Fel-Br/FYB/README.md

# FYB
Este repositório contém os compontentes CAD, seus respectivos detalhamentos técnicos e o código utilizado no projeto do Manipulador robótico palelo acionado por cabeamento 1R2T do trabalho de conclusão de curso de Felype Araujo Brasil.
