Fel-Br/FYB/STEP/fybufpr_asm.stp

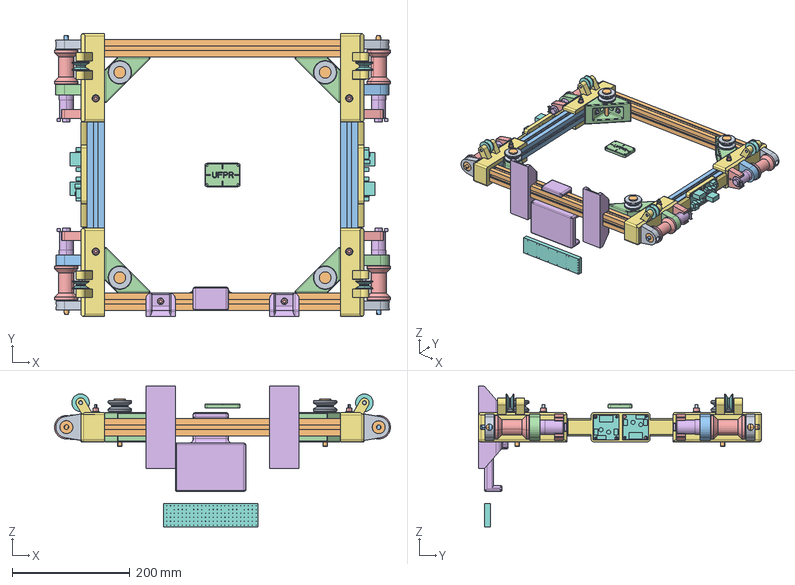
[picture p1: CAD file, 2025-05-26]
STEP/fybufpr_asm.stp
570.0 x 480.0 x 238.7 mm
FYBUFPR002 x 2
FYBUFPR001 x 2
FYBUFPR003 x 4
FYBUFPR004_001 x 2
MOTOR_6V_C-ENCODER x 4
FYBUFPR004_002 x 2
ACOP-HEX-M4 x 4
FYBUFPR004_003 x 2
ROLAMENTO x 8
FYBUFPR004_005 x 2
FYBUFPR004_006 x 2
FYBUFPR004_007 x 2
PARAF-ESC-M4X10 x 8
FYBUFPR004_004 x 2
FYBUFPR013_007 x 6
FYBUFPR005 x 4
FYBUFPR006 x 4
FYBUFPR007 x 4
PORCA_MARTELO_M8 x 17
ARUELA x 4
PARAF_M6X16 x 17
FYBUFPR011 x 2
FYBUFPR009 x 2
PONTEHL298N x 4
FYBUFPR012 x 4
FYBUFPR013_001 x 2
FYBUFPR013_002 x 2
FYBUFPR013_003 x 2
FYBUFPR013_004 x 2
FYBUFPR013_005 x 2
FYBUFPR013_006 x 2
FYBUFPR010
PARAF-M3-5X5 x 8
FYBUFPR008
PARAF_SEXTINT_ABAULADO_M8X16 x 4
PROTOBOARD
ARDUINO
