Fel-Br/FYB/STEP/fybufpr013_006.stp

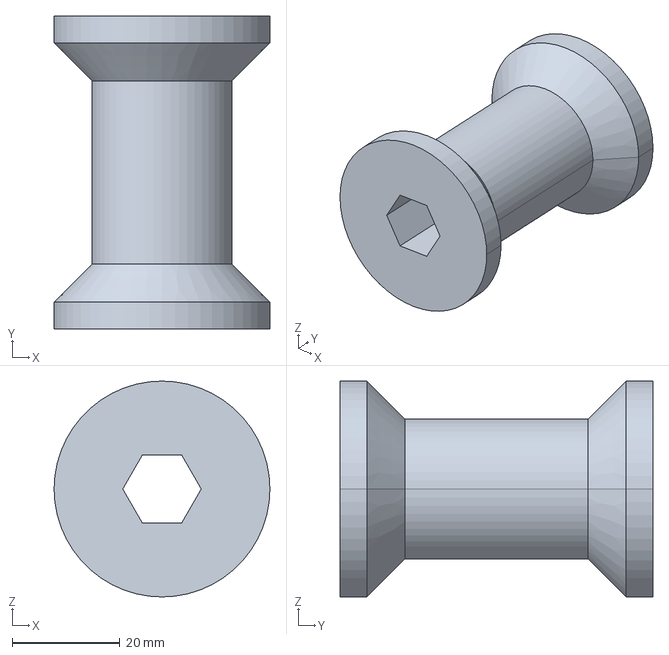
[picture p2: CAD file, 2025-05-26]
STEP/fybufpr013_006.stp
40.0 x 58.0 x 40.0 mm
