Fel-Br/FYB/Stl/fybufpr006_body_1_b.stl

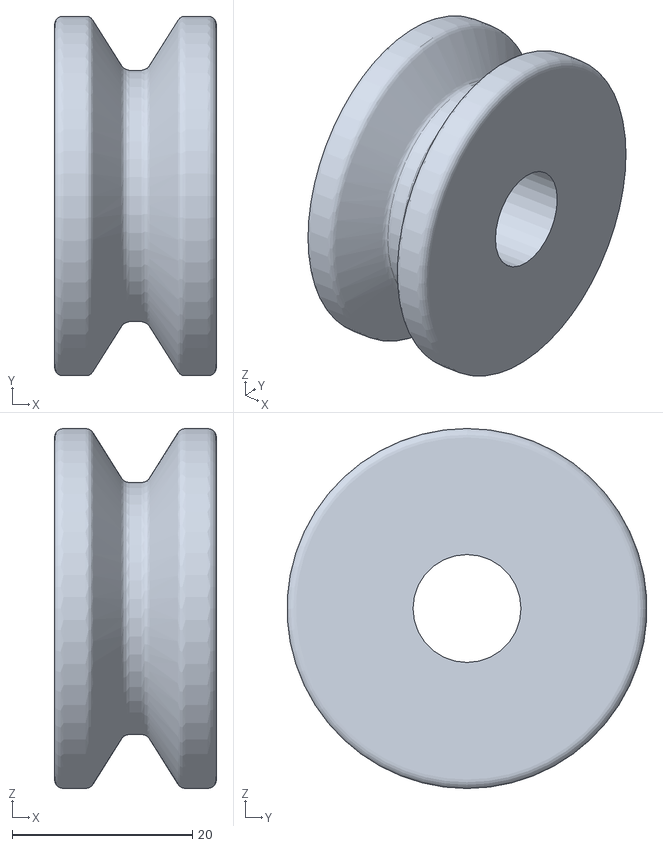
[picture p3: CAD file, 2025-05-26]
Stl/fybufpr006_body_1_b.stl
18.0 x 39.9 x 40.0
