Fel-Br/FYB/STEP/fybufpr013_004.stp

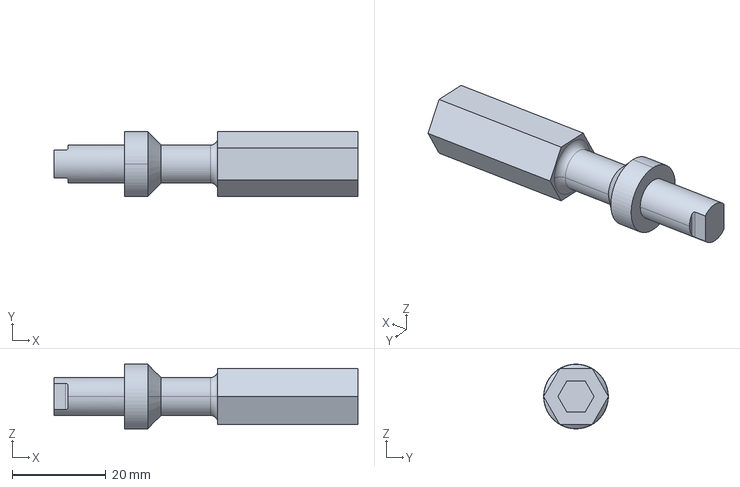
[picture p4: CAD file, 2025-05-26]
STEP/fybufpr013_004.stp
65.0 x 13.9 x 13.9 mm
