Fel-Br/FYB/Stl/fybufpr013_007_body_1_b.stl

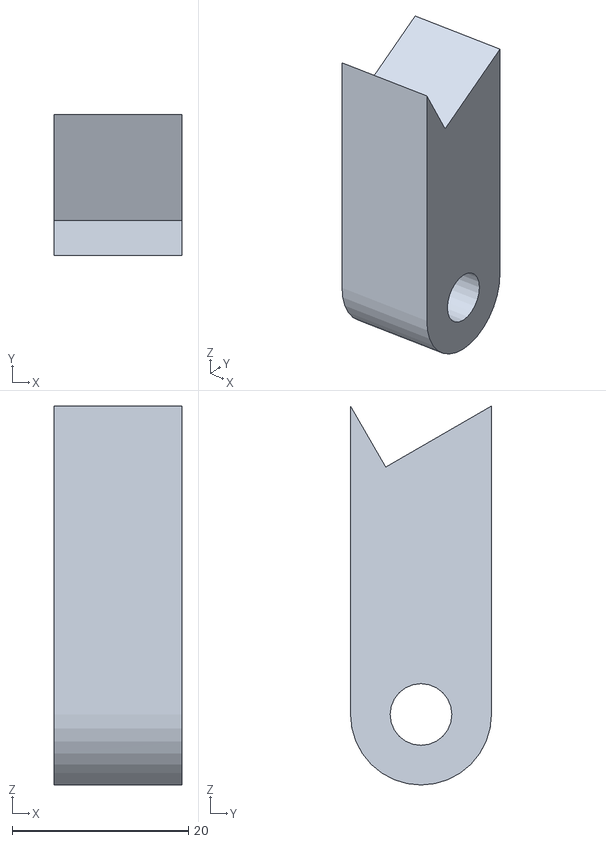
[picture p5: CAD file, 2025-05-26]
Stl/fybufpr013_007_body_1_b.stl
14.5 x 16.0 x 43.0
