Fel-Br/FYB/Stl/fybufpr004_003_body_1_b.stl

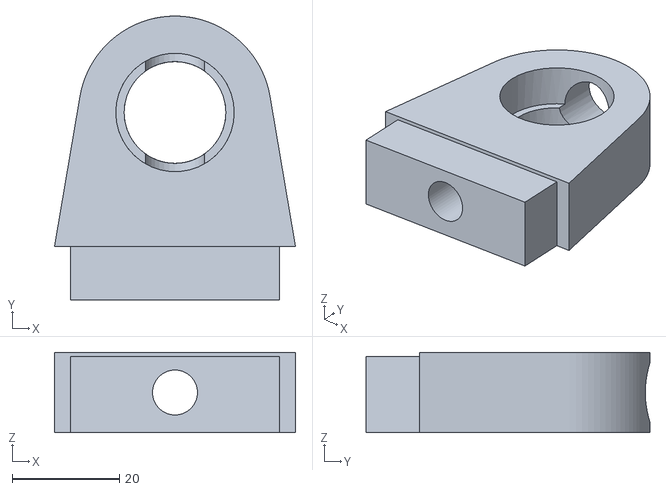
[picture p6: CAD file, 2025-05-26]
Stl/fybufpr004_003_body_1_b.stl
45.0 x 53.0 x 15.0
