Fel-Br/FYB/STEP/pontehl298n.stp

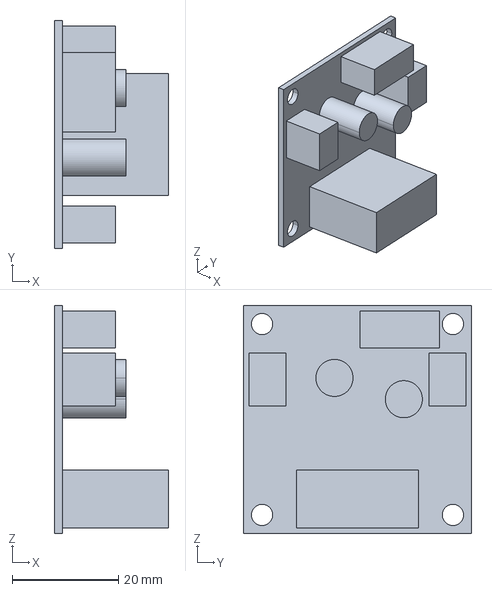
[picture p7: CAD file, 2025-05-26]
STEP/pontehl298n.stp
21.5 x 43.0 x 43.0 mm
