Fel-Br/FYB/STEP/paraf_m6x16.stp

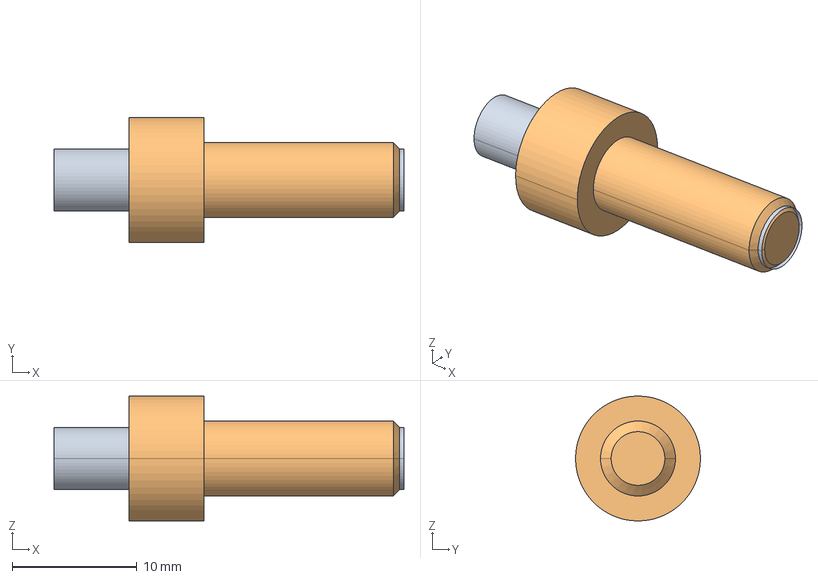
[picture p8: CAD file, 2025-05-26]
STEP/paraf_m6x16.stp
28.0 x 10.0 x 10.0 mm
