Fel-Br/FYB/Stl/fybufpr004_005_body_1_b.stl

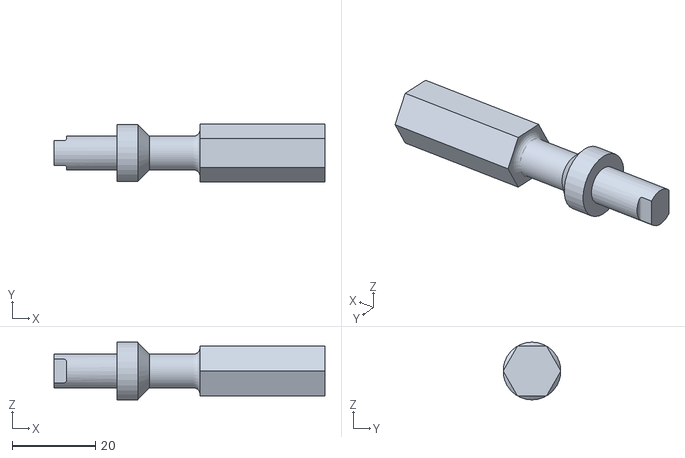
[picture p9: CAD file, 2025-05-26]
Stl/fybufpr004_005_body_1_b.stl
65.0 x 13.9 x 13.9
