Fel-Br/FYB/STEP/fybufpr001.stp

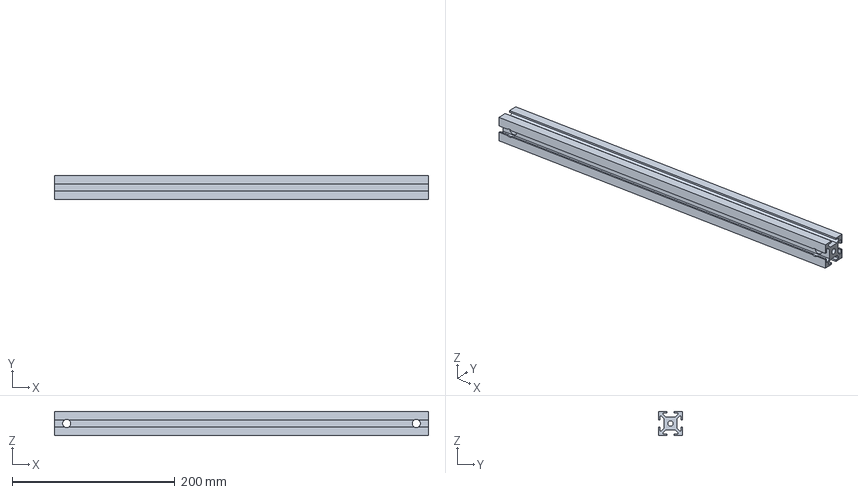
[picture p10: CAD file, 2025-05-26]
STEP/fybufpr001.stp
460.0 x 30.0 x 30.0 mm
