Fel-Br/FYB/Stl/fybufpr007_body_1_b.stl

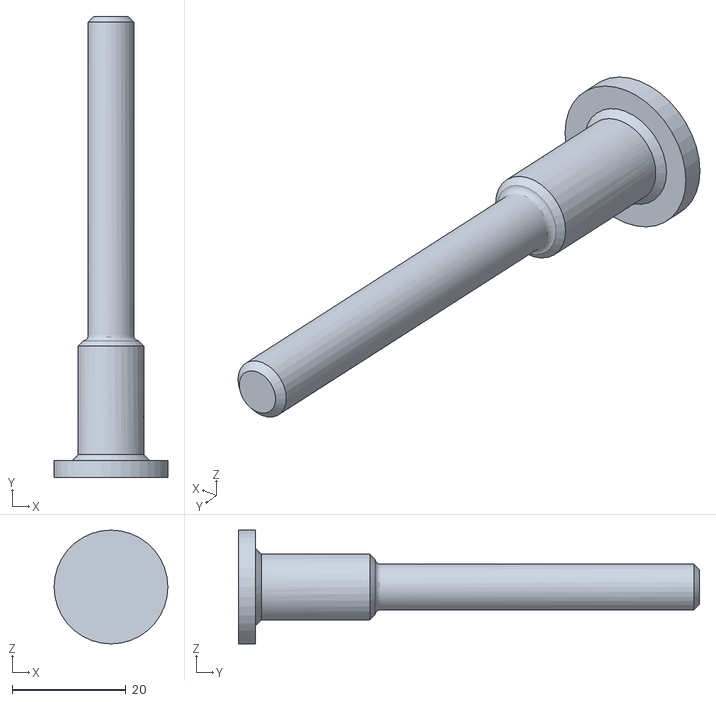
[picture p11: CAD file, 2025-05-26]
Stl/fybufpr007_body_1_b.stl
20.0 x 81.0 x 20.0
