Fel-Br/FYB/Stl/fybufpr004_001_body_1_b.stl

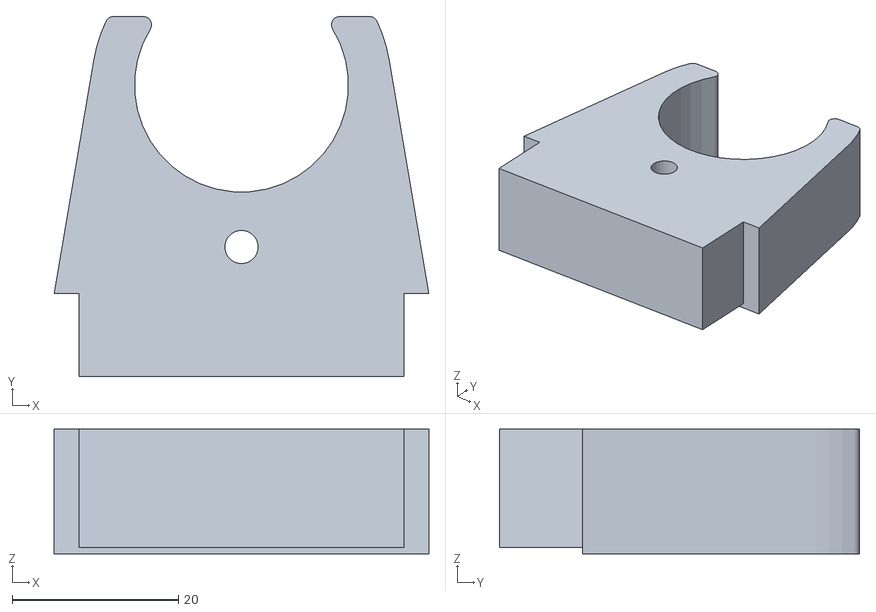
[picture p12: CAD file, 2025-05-26]
Stl/fybufpr004_001_body_1_b.stl
45.0 x 43.2 x 15.0
