Fel-Br/FYB/STEP/fybufpr004_006.stp

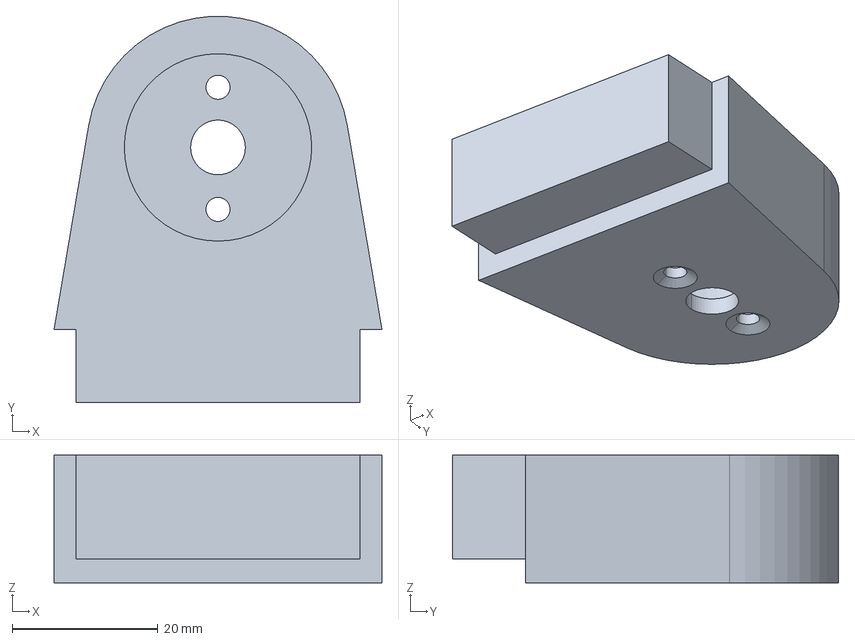
[picture p13: CAD file, 2025-05-26]
STEP/fybufpr004_006.stp
45.0 x 53.0 x 17.5 mm
