Fel-Br/FYB/Stl/fybufpr008_body_1_b.stl

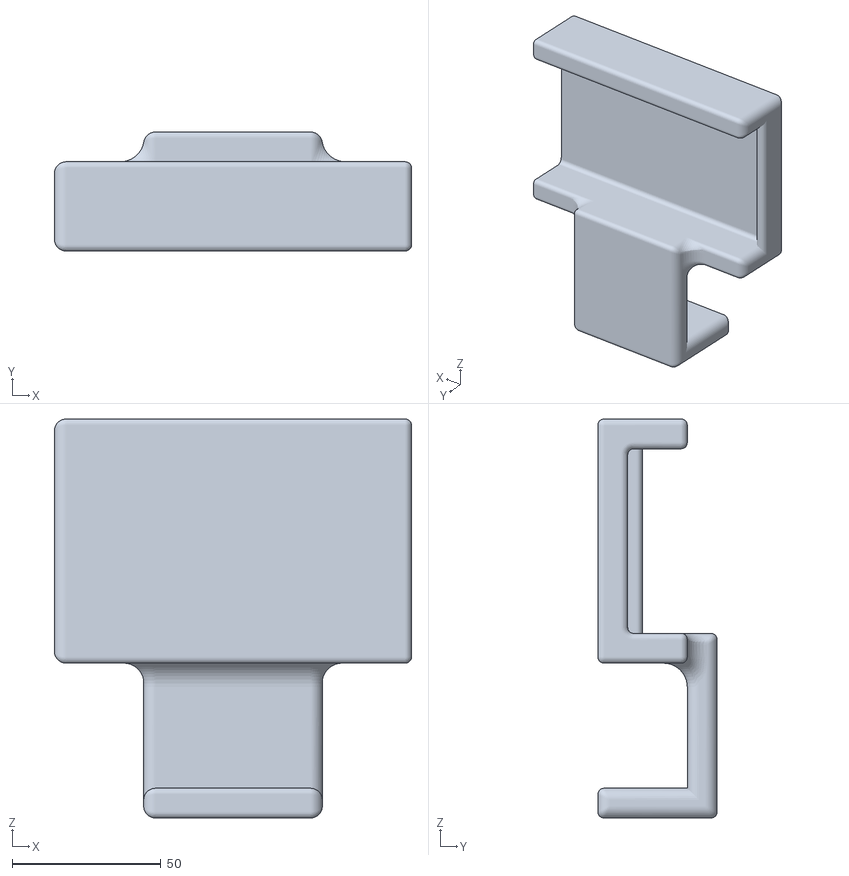
[picture p14: CAD file, 2025-05-26]
Stl/fybufpr008_body_1_b.stl
120.0 x 40.0 x 134.0
