Fel-Br/FYB/STEP/fybufpr011.stp

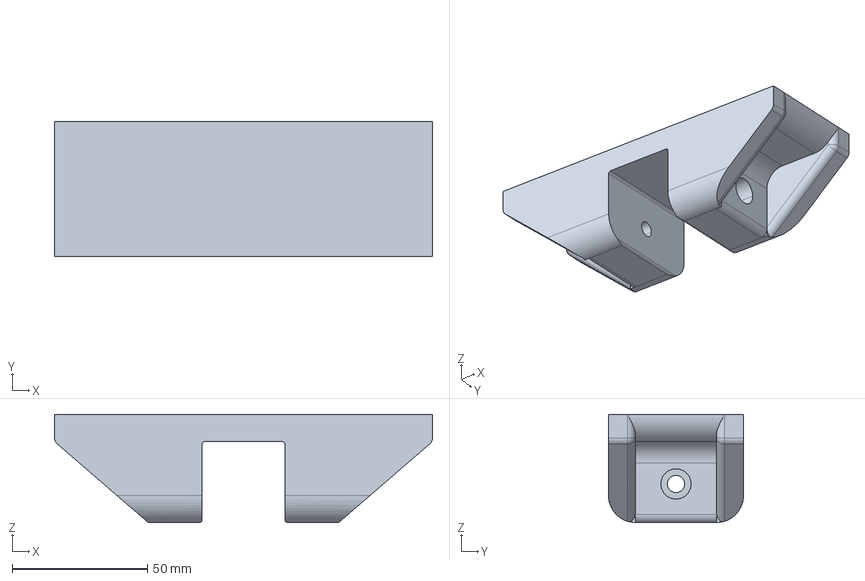
[picture p15: CAD file, 2025-05-26]
STEP/fybufpr011.stp
140.0 x 50.0 x 40.0 mm
