Fel-Br/FYB/Stl/fybufpr004_002_body_1_b.stl

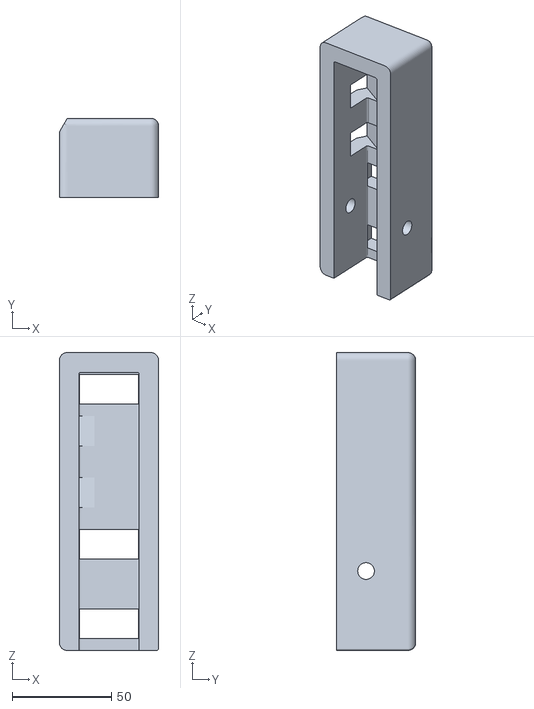
[picture p16: CAD file, 2025-05-26]
Stl/fybufpr004_002_body_1_b.stl
50.0 x 40.0 x 150.0
