Fel-Br/FYB/Stl/fybufpr010_body_1_b.stl

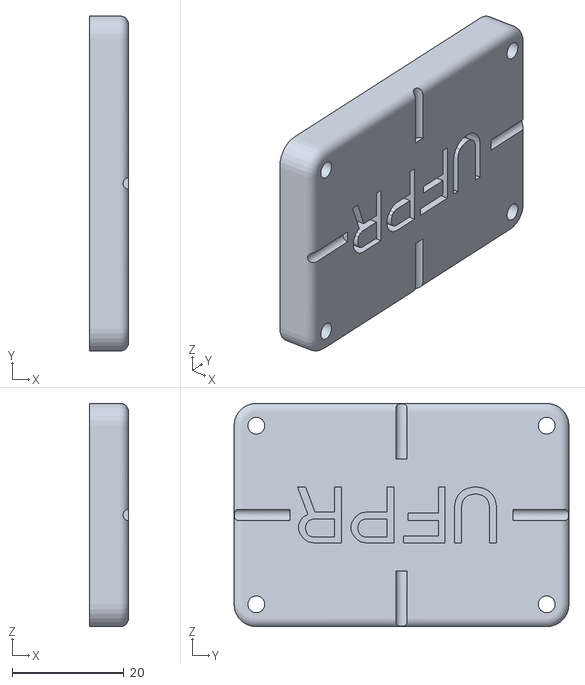
[picture p17: CAD file, 2025-05-26]
Stl/fybufpr010_body_1_b.stl
7.00 x 60.0 x 40.0
