Fel-Br/FYB/STEP/aruela.stp

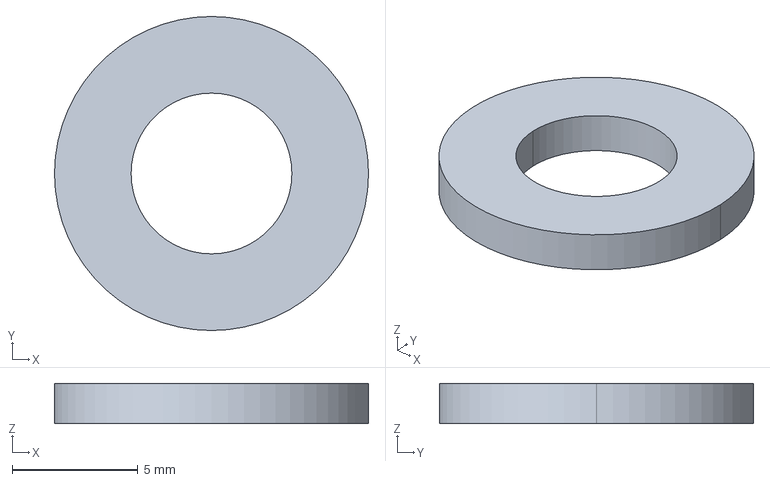
[picture p18: CAD file, 2025-05-26]
STEP/aruela.stp
12.5 x 12.5 x 1.60 mm
