Fel-Br/FYB/Stl/fybufpr005_body_1_b.stl

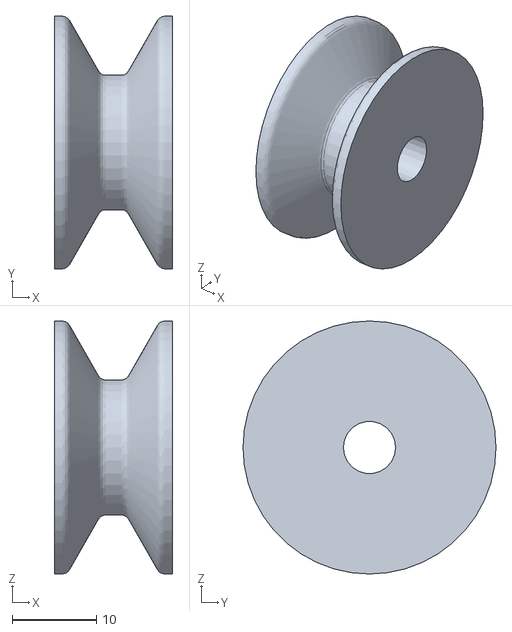
[picture p19: CAD file, 2025-05-26]
Stl/fybufpr005_body_1_b.stl
14.0 x 30.0 x 30.0
