Fel-Br/FYB/STEP/paraf-esc-m4x10.stp

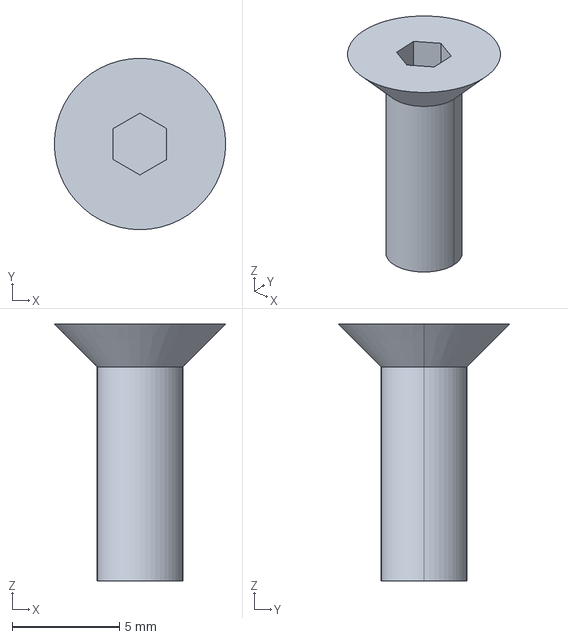
[picture p20: CAD file, 2025-05-26]
STEP/paraf-esc-m4x10.stp
8.00 x 8.00 x 12.0 mm
