Fel-Br/FYB/STEP/protoboard.stp

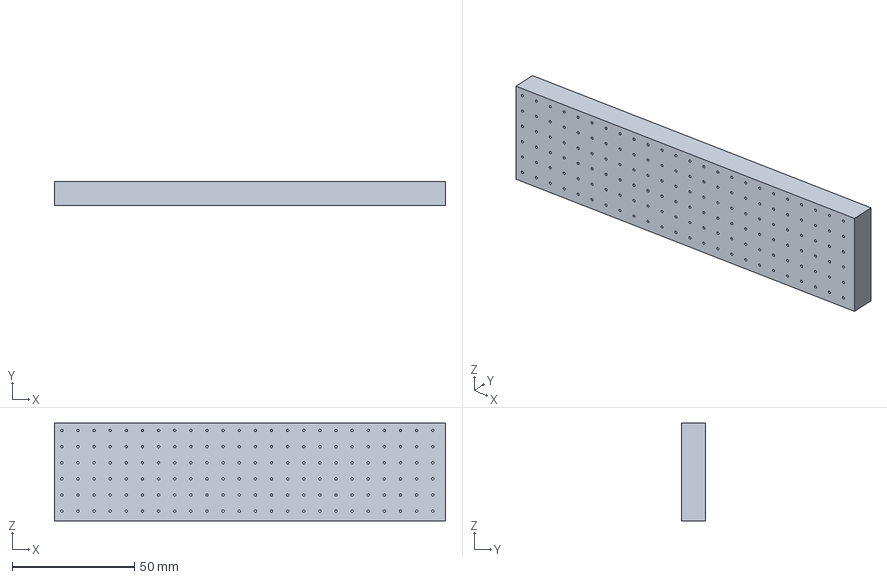
[picture p21: CAD file, 2025-05-26]
STEP/protoboard.stp
160.0 x 10.0 x 40.0 mm
