Fel-Br/FYB/STEP/rolamento.stp

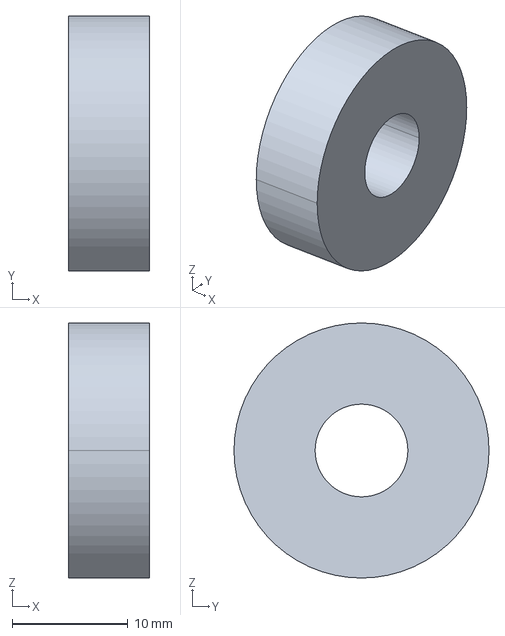
[picture p22: CAD file, 2025-05-26]
STEP/rolamento.stp
7.00 x 22.0 x 22.0 mm
