Fel-Br/FYB/Stl/fybufpr009_body_1_b.stl

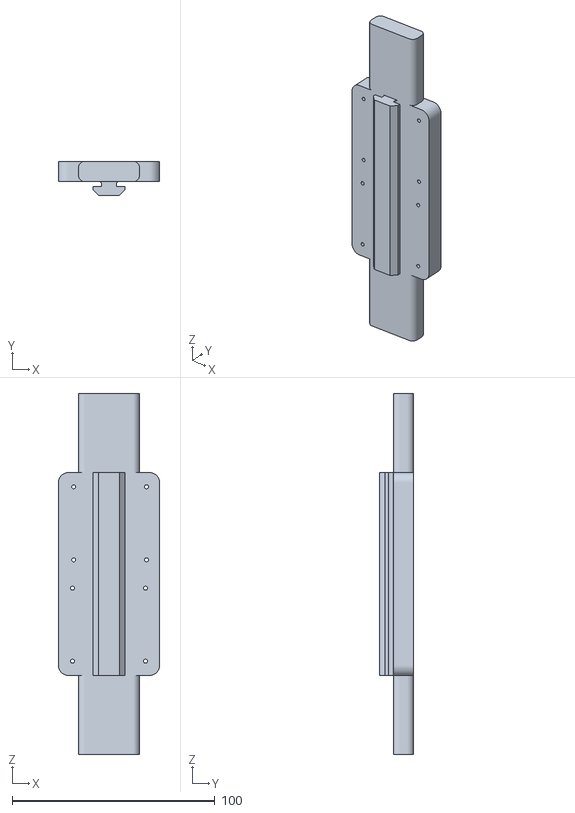
[picture p23: CAD file, 2025-05-26]
Stl/fybufpr009_body_1_b.stl
50.0 x 16.9 x 178.0
