Fel-Br/FYB/STEP/fybufpr002.stp

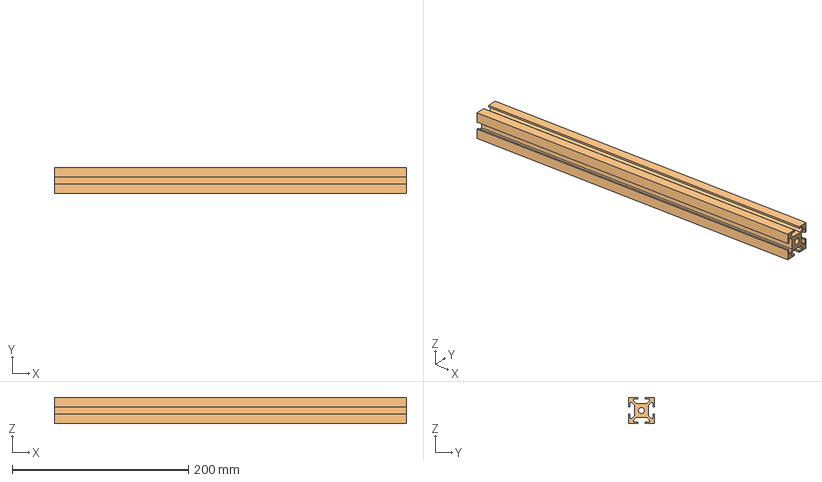
[picture p24: CAD file, 2025-05-26]
STEP/fybufpr002.stp
400.0 x 30.0 x 30.0 mm
