Fel-Br/FYB/STEP/fybufpr013_005.stp

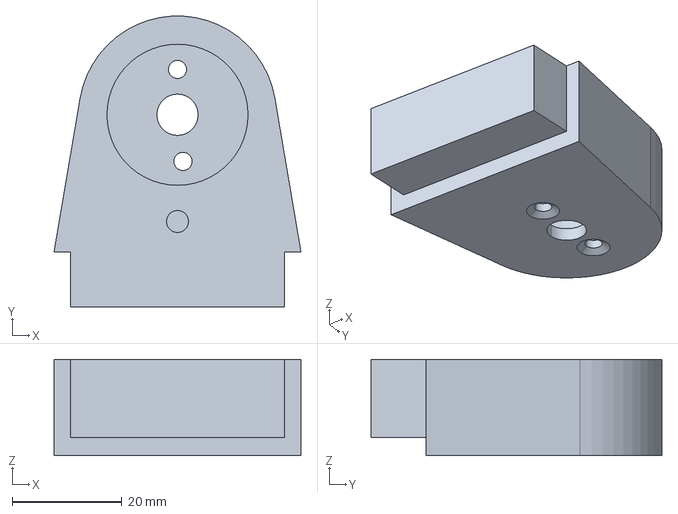
[picture p25: CAD file, 2025-05-26]
STEP/fybufpr013_005.stp
45.0 x 53.0 x 17.5 mm
