Fel-Br/FYB/STEP/motor_6v_c-encoder.stp

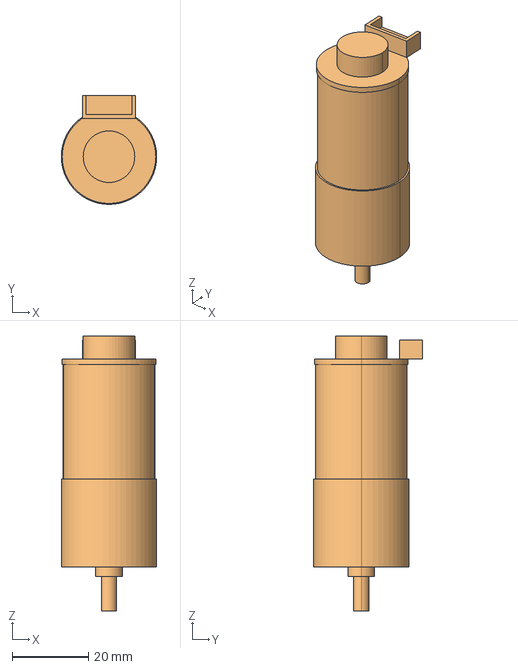
[picture p26: CAD file, 2025-05-26]
STEP/motor_6v_c-encoder.stp
25.0 x 28.5 x 72.0 mm
