Fel-Br/FYB/Stl/fybufpr002_body_1_b.stl

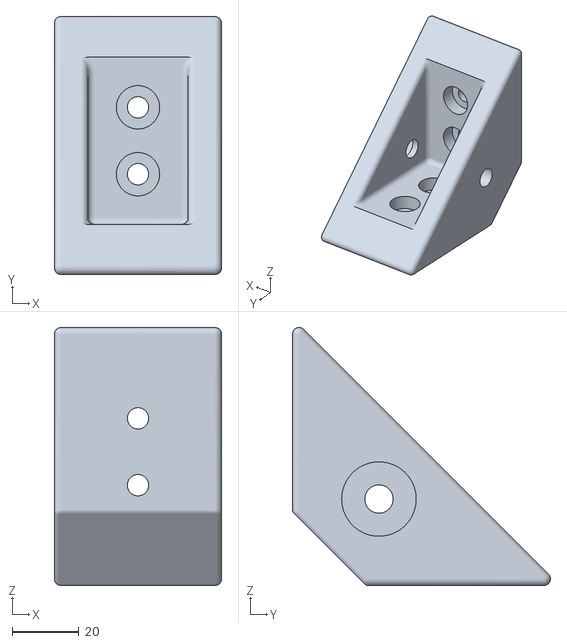
[picture p27: CAD file, 2025-05-26]
Stl/fybufpr002_body_1_b.stl
50.0 x 77.2 x 77.2
