Fel-Br/FYB/STEP/acop-hex-m4.stp

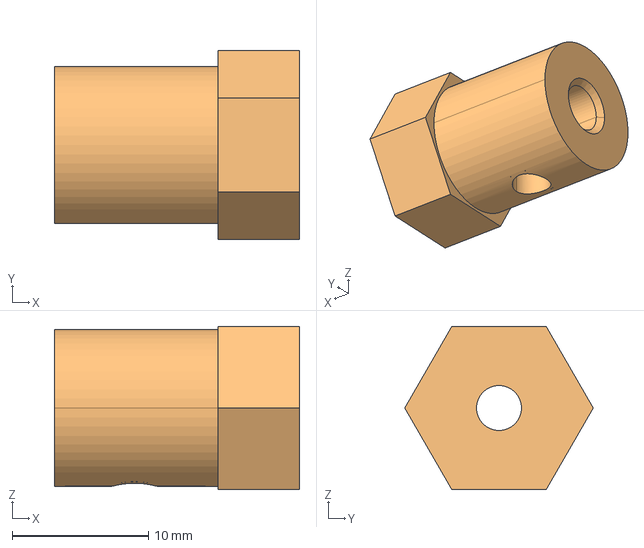
[picture p28: CAD file, 2025-05-26]
STEP/acop-hex-m4.stp
18.0 x 13.9 x 12.0 mm
