Fel-Br/FYB/STEP/arduino.stp

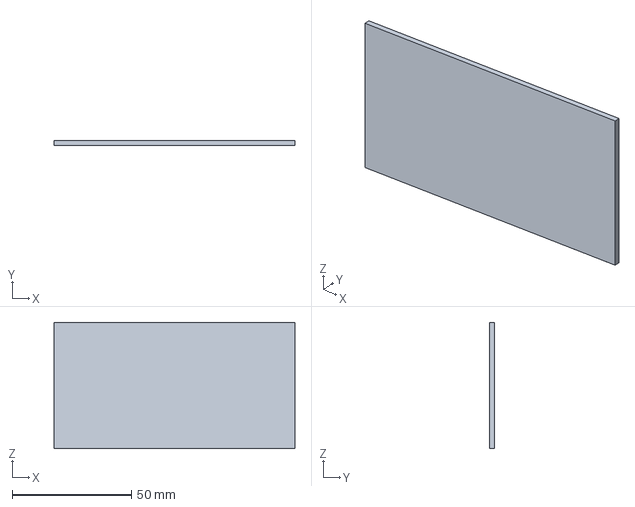
[picture p29: CAD file, 2025-05-26]
STEP/arduino.stp
101.0 x 2.00 x 53.0 mm
