Fel-Br/FYB/STEP/fybufpr012.stp

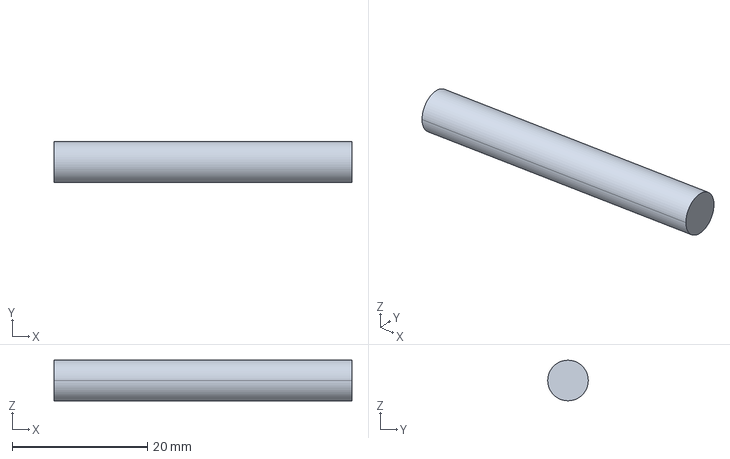
[picture p30: CAD file, 2025-05-26]
STEP/fybufpr012.stp
44.0 x 6.00 x 6.00 mm
