Fel-Br/FYB/STEP/porca_martelo_m8.stp

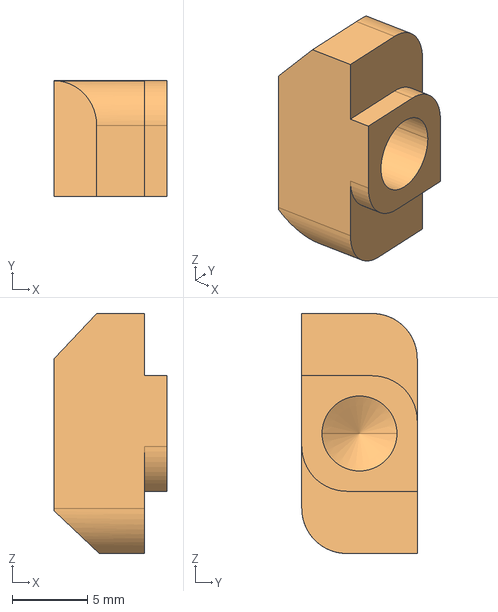
[picture p31: CAD file, 2025-05-26]
STEP/porca_martelo_m8.stp
7.50 x 7.70 x 16.0 mm
