Fel-Br/FYB/(list of files, cad)

Other CAD files:
STEP/fybufpr006.stp
Stl/fybufpr004_004_body_1_b.stl
STEP/fybufpr013_003.stp
STEP/fybufpr008.stp
STEP/fybufpr013_001.stp
Stl/fybufpr013_004_body_1_b.stl
Stl/fybufpr013_002_body_1_b.stl
Stl/fybufpr004_006_body_1_b.stl
Stl/fybufpr004_007_body_1_b.stl
Stl/fybufpr013_001_body_1_b.stl
STEP/fybufpr004_007.stp
Stl/fybufpr013_005_body_1_b.stl
STEP/fybufpr010.stp
Stl/fybufpr013_003_body_1_b.stl
Stl/fybufpr011_body_1_b.stl
Stl/fybufpr013_006_body_1_b.stl
STEP/fybufpr013_002.stp
STEP/fybufpr013_007.stp
STEP/fybufpr003.stp
STEP/fybufpr004_004.stp
STEP/fybufpr004_002.stp
STEP/fybufpr004_001.stp
STEP/fybufpr005.stp
STEP/fybufpr004_005.stp
STEP/fybufpr007.stp
STEP/fybufpr009.stp
