Fel-Br/FYB/FYB_DETALHAMENTO_TÉCNICO.pdf

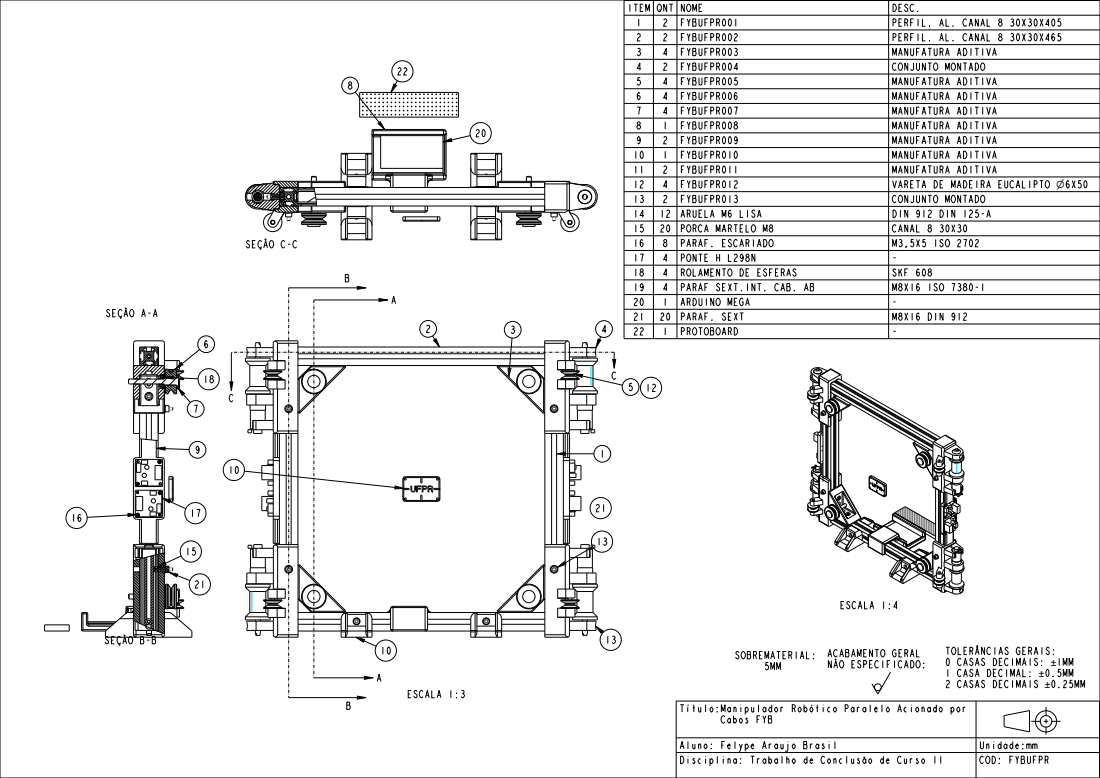
[picture p32: page 1]
Aluno: Felype Araujo Brasil; Unidade:mm; Disciplina: Trabalho de Conclusão de Curso II; COD: FYBUFPR; ITEM QNT NOME; DESC.; 2 FYBUFPR001; PERFIL. AL. CANAL; 2 FYBUFPR002; 4 FYBUFPR003; MANUFATURA ADITIVA; 2 FYBUFPR004; CONJUNTO MONTADO; 4 FYBUFPR005; 4 FYBUFPR006; 4 FYBUFPR007; 1 FYBUFPR008; 2 FYBUFPR009; 10 1 FYBUFPR010; 11 2 FYBUFPR011; 12 4 FYBUFPR012; VARETA DE; MADEIRA EUCALIPTO ⌀6X50; 13 2 FYBUFPR013; 14 12 ARUELA M6 LISA; DIN 912 DIN 125-A; 15 20 PORCA MARTELO M8; CANAL 8 30X30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

Título:Manipulador Robótico Paralelo Acionado por
Cabos FYB

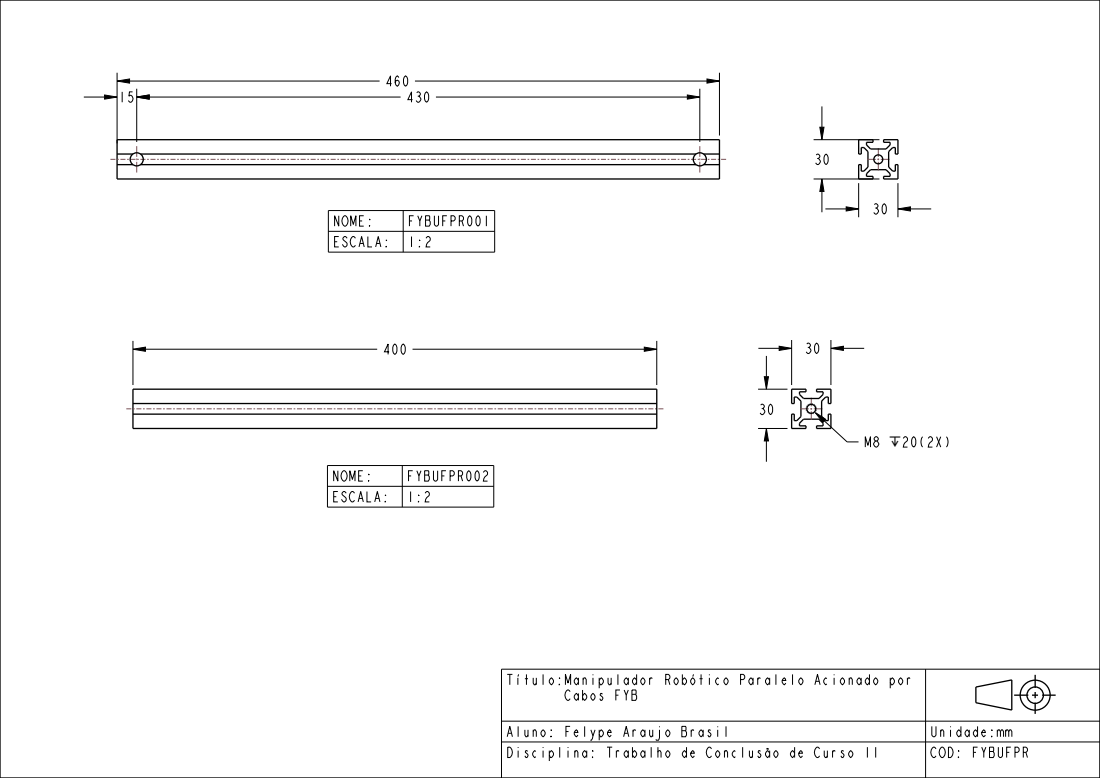
[picture p33: page 2]

NOME: | FYBUFPR001
ESCALA: | | 1:2

NOME: | FYBUFPR002

Título:Manipulador Robótico Paralelo Acionado por
Cabos FYB

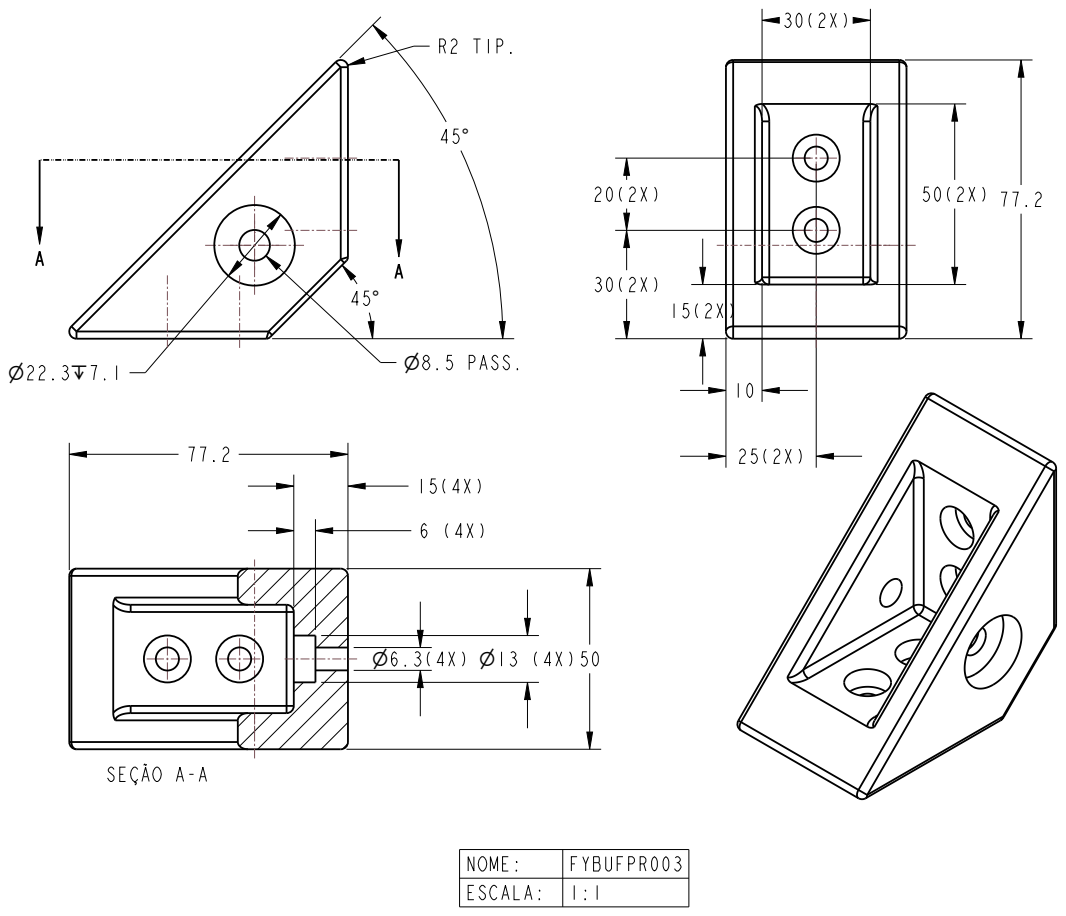
[picture p34: page 3]
R2 TIP.; ⌀8.5 PASS. ⌀22.3↧7.1; SEÇÃO A-A

Título:Manipulador Robótico Paralelo Acionado por

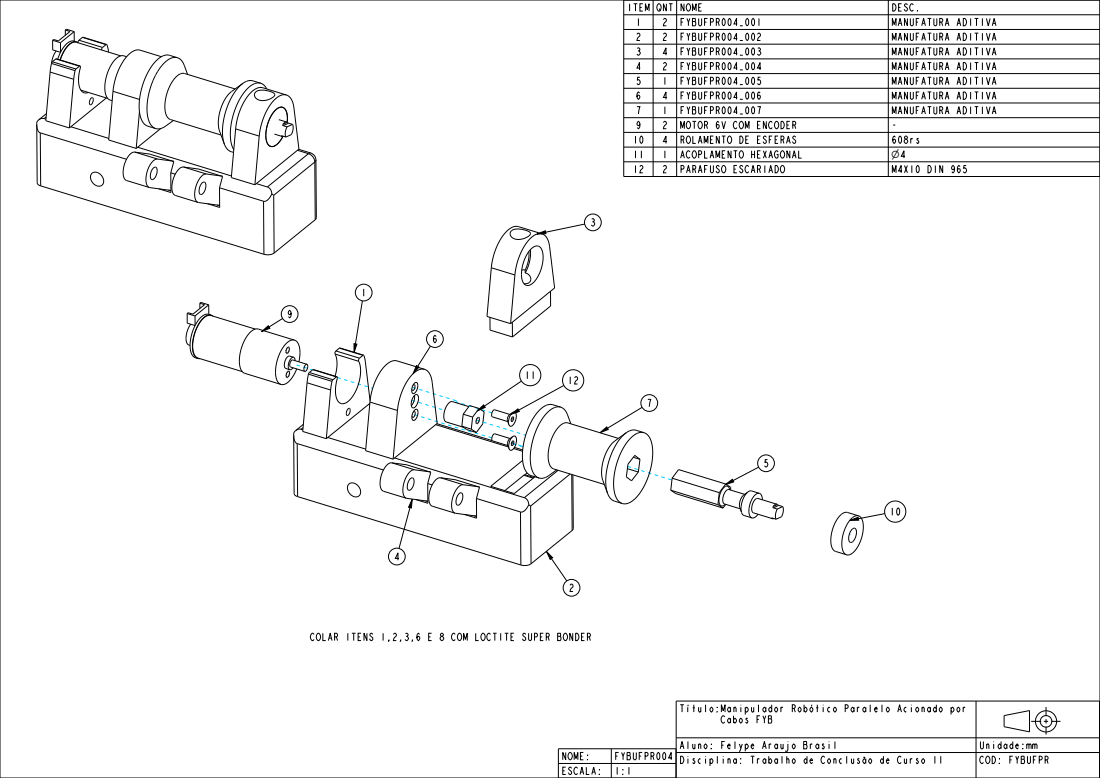
[picture p35: page 4]
Disciplina: Trabalho de Conclusão de Curso II; COD: FYBUFPR NOME:; FYBUFPR004; FYBUFPR004_001; MANUFATURA ADITIVA; FYBUFPR004_002; FYBUFPR004_003; FYBUFPR004_004; FYBUFPR004_005; FYBUFPR004_006; FYBUFPR004_007; MOTOR 6V COM ENCODER; ROLAMENTO DE; ESFERAS; ACOPLAMENTO HEXAGONAL; COLAR ITENS 1,2,3,6 E; 8 COM LOCTITE; SUPER BONDER

12 | 2 | PARAFUSO ESCARIADO | M4X10 DIN 965

Título:Manipulador Robótico Paralelo Acionado por

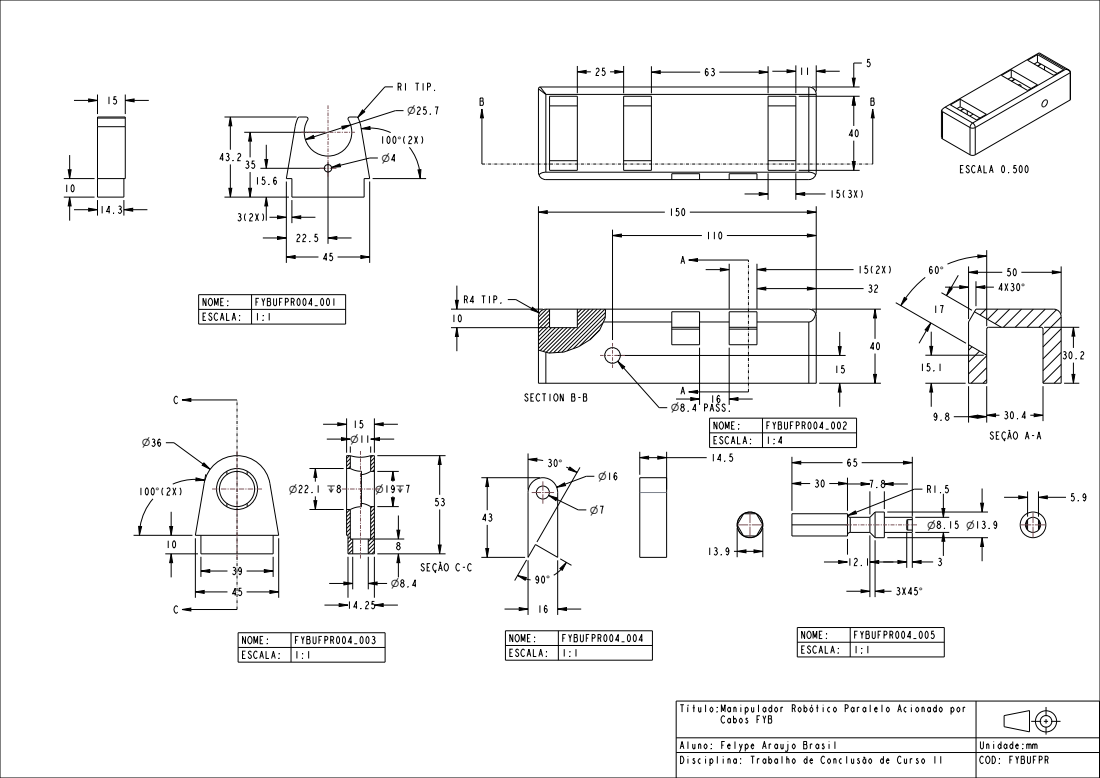
[picture p36: page 5]
R4 TIP.; ⌀8.4 PASS.; R1 TIP.; ESCALA 0.500; SECTION B-B; SEÇÃO A-A; SEÇÃO C-C

NOME: | FYBUFPR004_002
ESCALA: | | 1:4

NOME: | FYBUFPR004_005
ESCALA: | | 1:1

NOME: | FYBUFPR004_003

Título:Manipulador Robótico Paralelo Acionado por

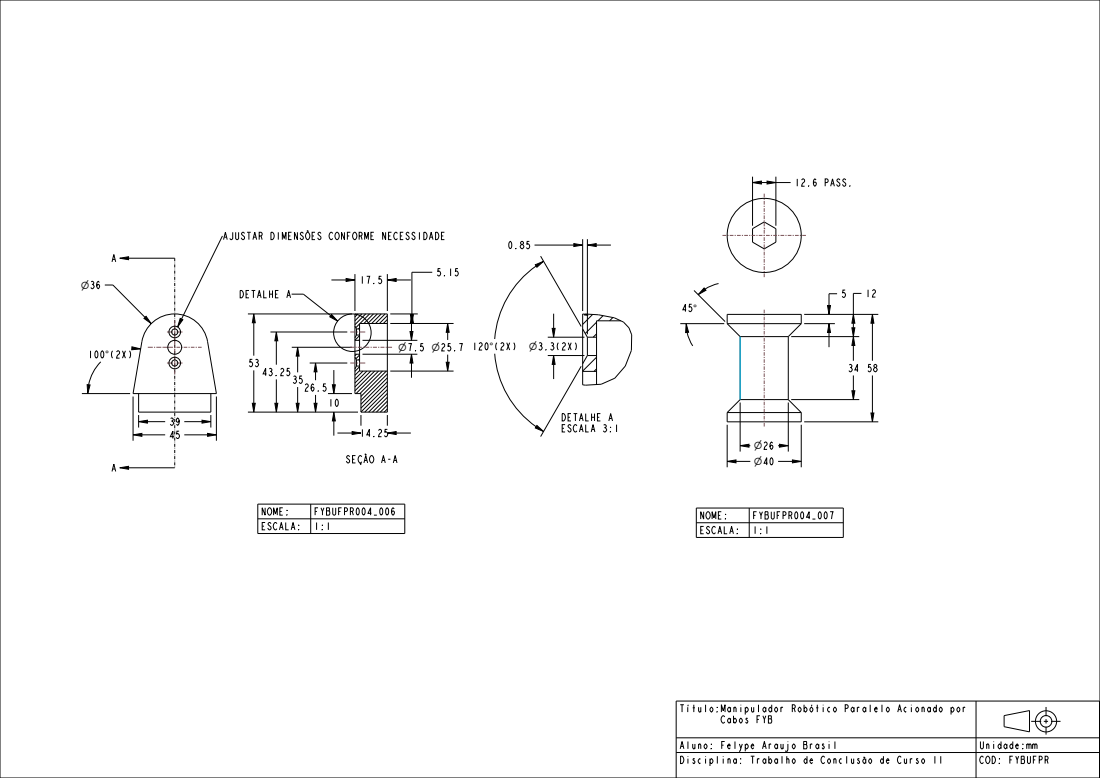
[picture p37: page 6]
12.6 PASS.; AJUSTAR DIMENSÕES CONFORME; NECESSIDADE; SEÇÃO A-A; ESCALA 3:1

NOME: | FYBUFPR004_007
ESCALA: | | 1:1

Título:Manipulador Robótico Paralelo Acionado por

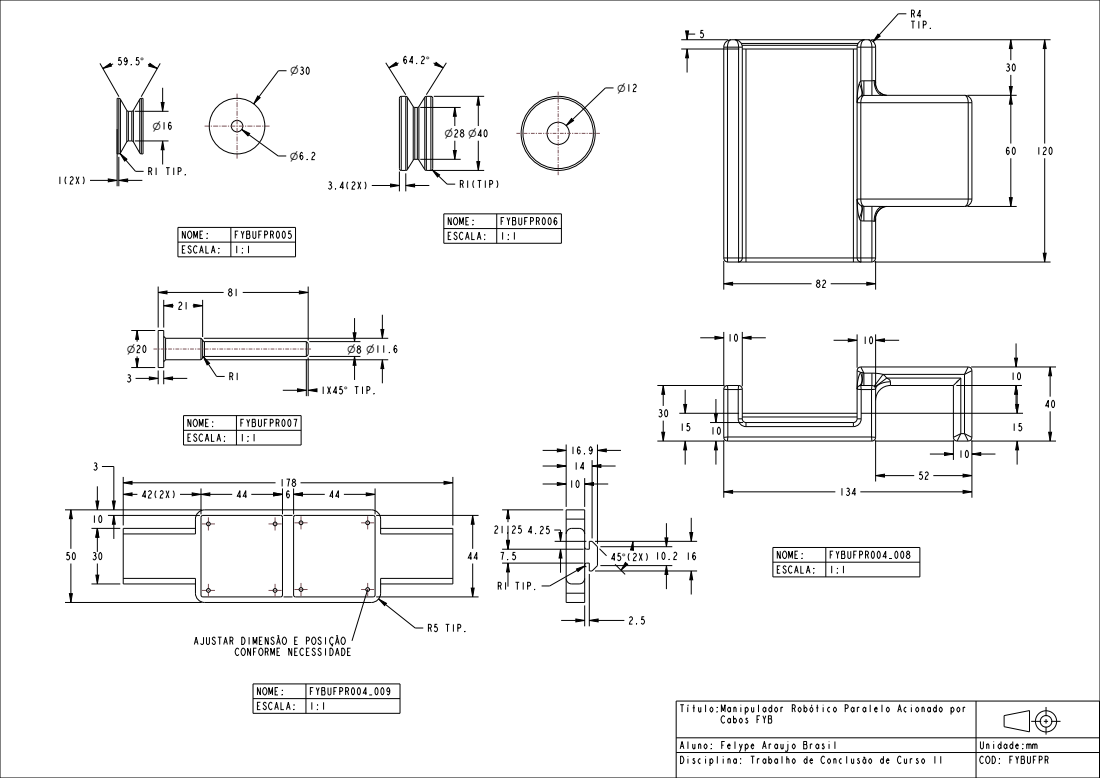
[picture p38: page 7]
R1 TIP.; 1X45° TIP.; R5 TIP.; AJUSTAR DIMENSÃO E; POSIÇÃO

NOME: | FYBUFPR007
ESCALA: | | 1:1

NOME: | FYBUFPR004_008

NOME: | FYBUFPR004_009

Título:Manipulador Robótico Paralelo Acionado por

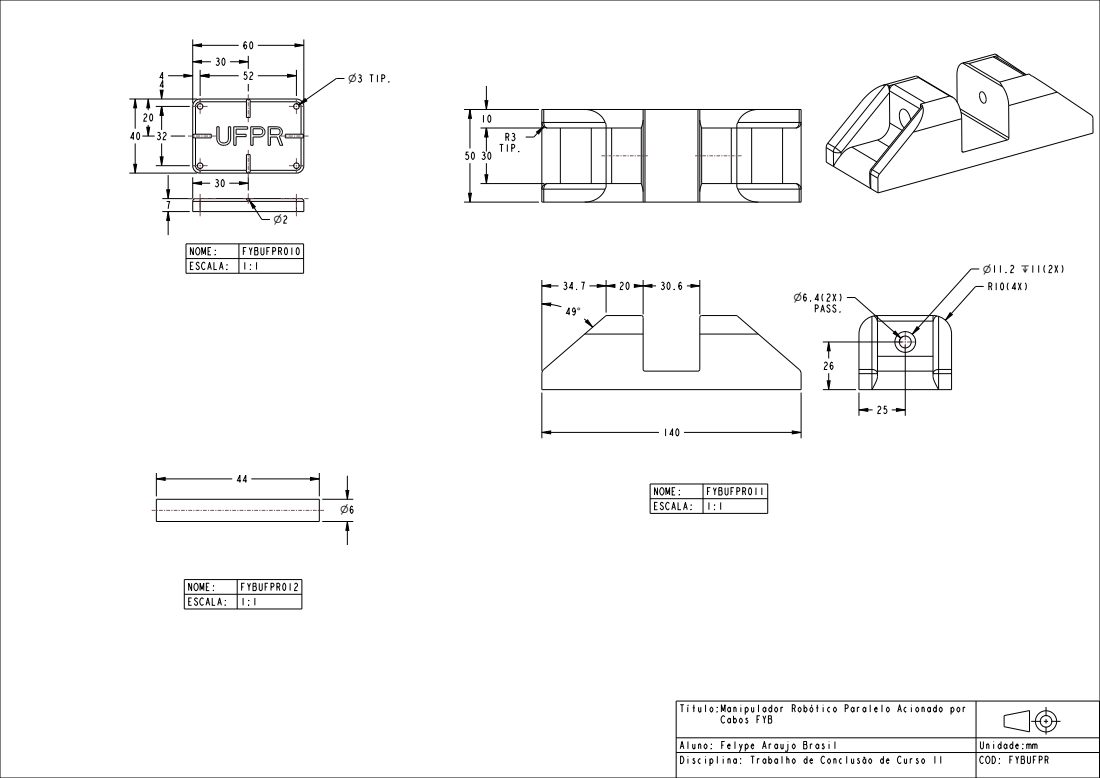
[picture p39: page 8]
⌀3 TIP.

NOME: | FYBUFPR011
ESCALA: | | 1:1

NOME: | FYBUFPR012

Título:Manipulador Robótico Paralelo Acionado por

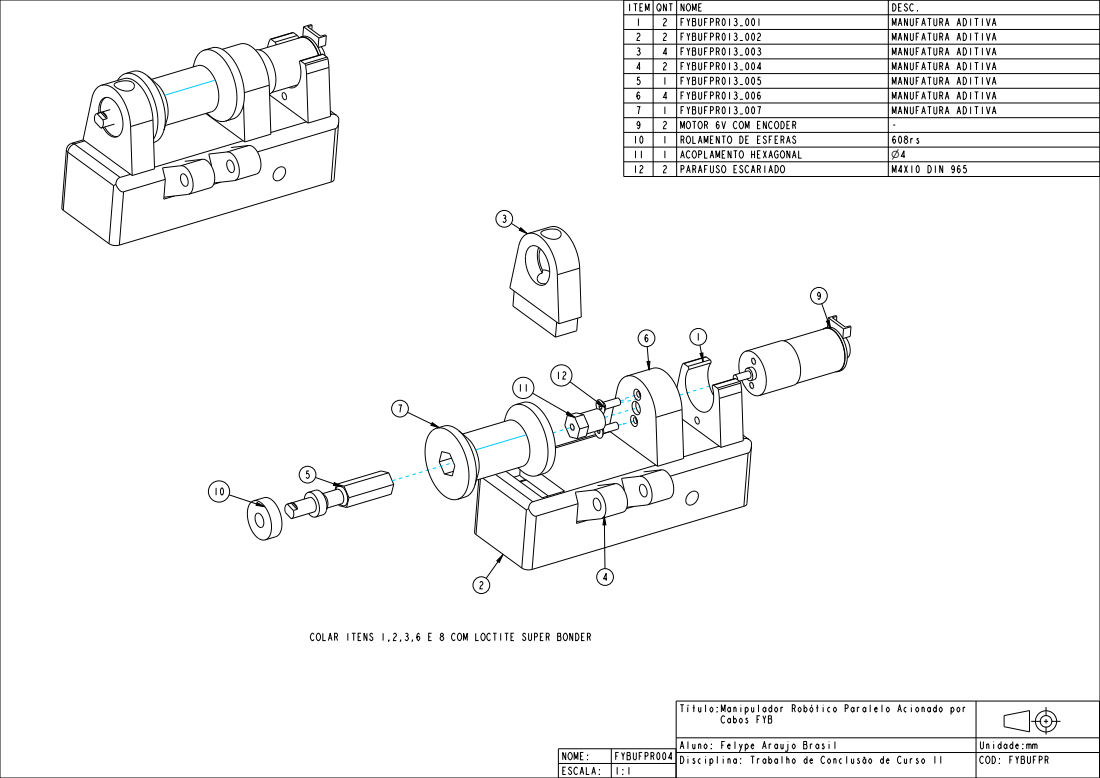
[picture p40: page 9]
Disciplina: Trabalho de Conclusão de Curso II; COD: FYBUFPR NOME:; FYBUFPR004; FYBUFPR013_001; MANUFATURA ADITIVA; FYBUFPR013_002; FYBUFPR013_003; FYBUFPR013_004; FYBUFPR013_005; FYBUFPR013_006; FYBUFPR013_007; MOTOR 6V COM ENCODER; ROLAMENTO DE; ESFERAS; ACOPLAMENTO HEXAGONAL; COLAR ITENS 1,2,3,6 E; 8 COM LOCTITE; SUPER BONDER

12 | 2 | PARAFUSO ESCARIADO | M4X10 DIN 965

Título:Manipulador Robótico Paralelo Acionado por

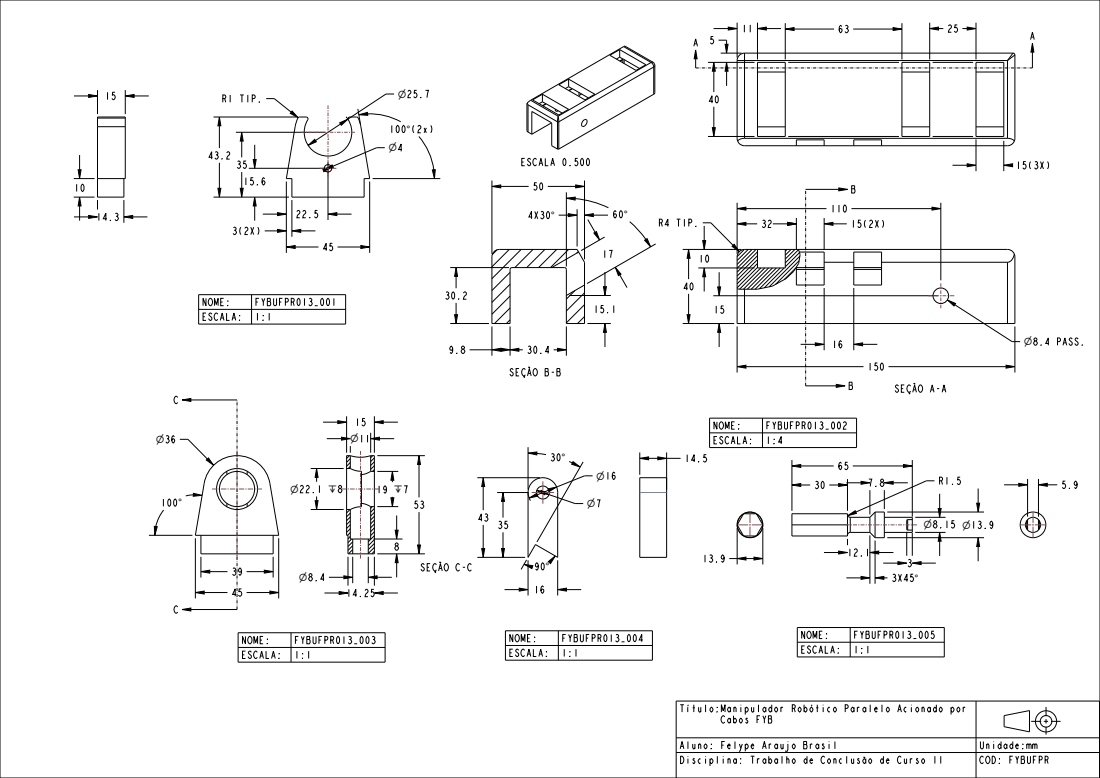
[picture p41: page 10]
R1 TIP.; ⌀8.4 PASS.; R4 TIP.; SEÇÃO C-C; SEÇÃO A-A; SEÇÃO B-B; ESCALA 0.500

NOME: | FYBUFPR013_002
ESCALA: | | 1:4

NOME: | FYBUFPR013_005
ESCALA: | | 1:1

NOME: | FYBUFPR013_003

Título:Manipulador Robótico Paralelo Acionado por

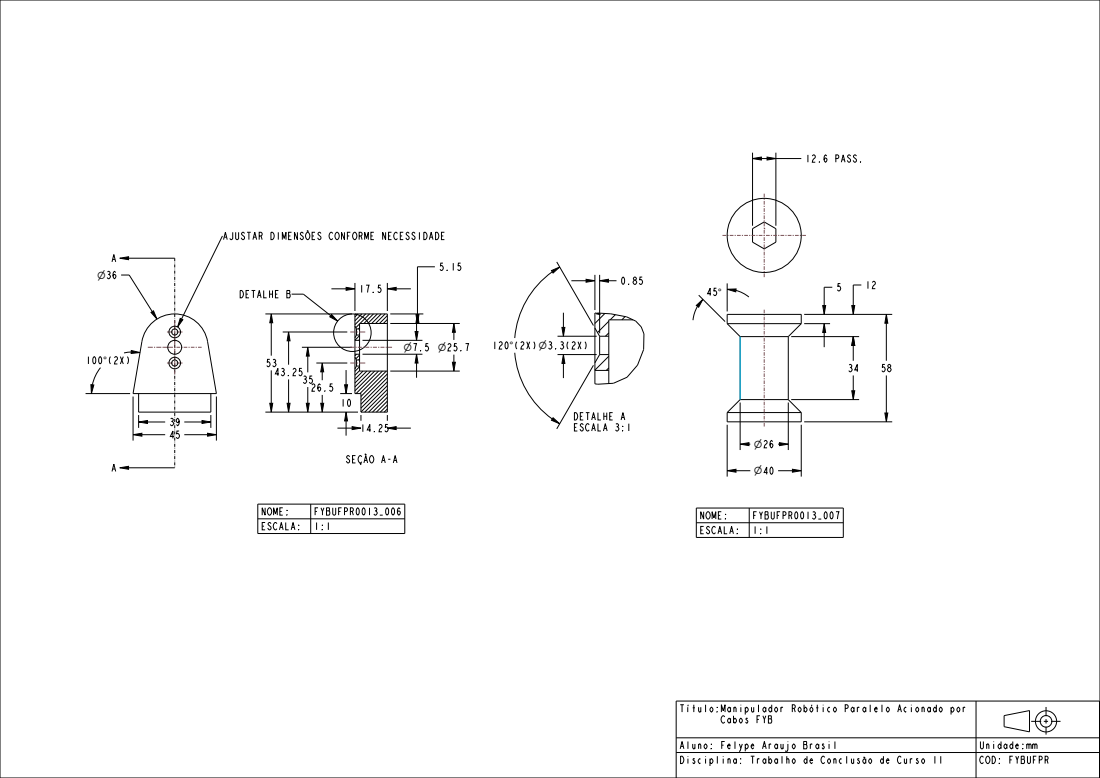
[picture p42: page 11]
12.6 PASS.; AJUSTAR DIMENSÕES CONFORME; NECESSIDADE; SEÇÃO A-A; ESCALA 3:1

NOME: | FYBUFPR0013_007
ESCALA: | | 1:1

Título:Manipulador Robótico Paralelo Acionado por
